diyaudioby/thsada/docs/thsada-sch.png

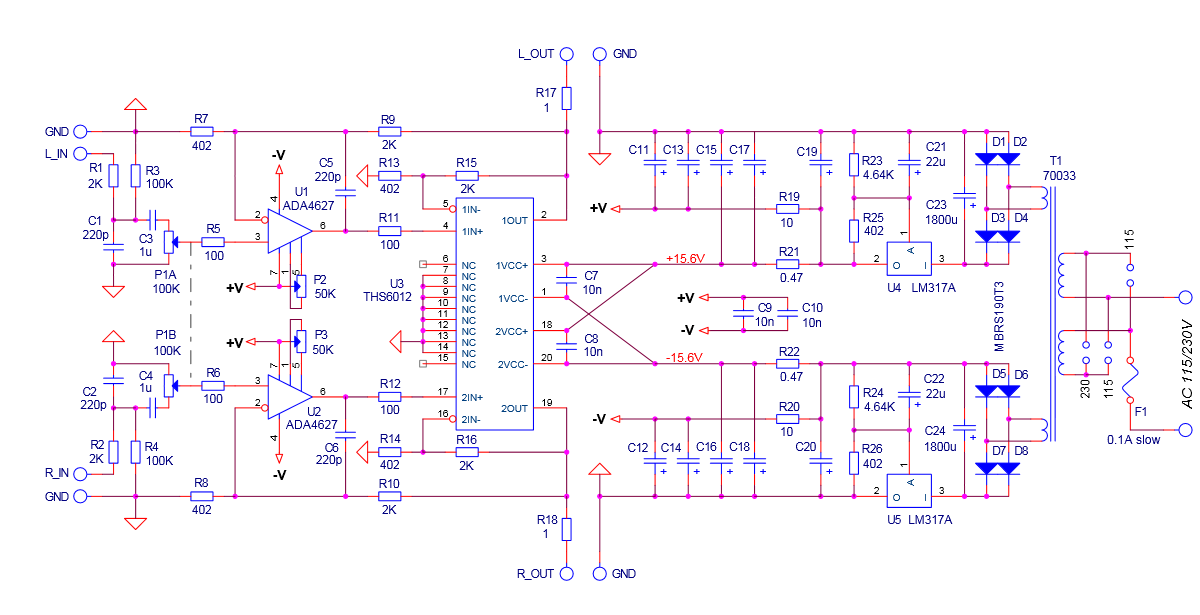
docs/thsada-sch.png
