diyaudioby/thsada/bom/thsada-bom.xlsx

Reference | Value | Case | Manufacture | Manufacture PN | Digikey PN | Qty 1
C1,C2,C5,C6 | 220pF x 50V 5% (NPO) | SMD 1206 | Yageo | CC1206JRNPO9BN221 | 311-1433-1-ND | 4
C3,C4 | 1uF x 63V 2% (LS 15mm) |  | Vishay BC Components | BFC241671005 | BC2076-ND | 2
C7…C10 | 10nF x 50V 5% (NPO) | SMD 1206 | Murata | GRM3195C1H103JA01D | 490-1754-1-ND | 4
C11…C14 | 100uF x 25V | TH D6.3xH12.7/LS=2.5mm | Panasonic (FM) | EEU-FM1E101 | P12924-ND | 4
C15…C18 | 470uF x 25V | TH D10xH17.5/LS=5mm | Panasonic (FM) | EEU-FM1E471 | P12388-ND | 4
C19…C22 | 22uF x 50V | TH D5xH12.5/LS=2mm | Panasonic (FM) | EEU-FM1H220 | P12927-ND | 4
C23,C24 | 1800uF x 35V | TH D16xH27/LS=7.5mm | Panasonic (FM) | EEU-FM1V182 | P12410-ND | 2
R1,R2,R9,R10,R15,R16 | 2k 1% 0.25W | SMD 1206 | Yageo | RC1206FR-072KL | 311-2.00KFRCT-ND | 6
R3,R4 | 100k 1% 0.25W | SMD 1206 | Yageo | RC1206FR-07100KL | 311-100KFRCT-ND | 2
R5,R6,R11,R12 | 100 1% 0.25W | SMD 1206 | Yageo | RC1206FR-07100RL | 311-100FRCT-ND | 4
R7,R8,R13,R14,R25,R26 | 402 Om 1% 0.25W | SMD 1206 | Yageo | RC1206FR-07402RL | 311-402FRCT-ND | 6
R17,R18 | 1 Om 5% 0.5W |  | Yageo | CFR-50JB-52-1R | 1.0H-ND | 2
R19,R20 | 11 Om 1% 0.25W | SMD 1206 | Yageo | RC1206FR-0711RL | 311-11.0FRCT-ND | 2
R21,R22 | 0.47 Om 0.5W
R23,R24 | 4.64k 1% 0.25W | SMD 1206 | Yageo | RC1206FR-074K64L | 311-4.64KFRCT-ND | 2
U1,U2 | ADA4627 | SOIC-8 | Analog Devices | ADA4627-1ARZ | ADA4627-1ARZ-ND | 2
U3 | THS6012 | SOIC-20 | Texas Instruments | THS6012IDWP | 296-1767-5-ND | 1
U4,U5 | LM317AT | TO-220-3 | Texas Instruments | LM317AT | LM317AT-ND | 2
D1…D8 | MBRS190 | SMB | ON Semiconductor | MBRS190T3G | MBRS190T3GOSCT-ND | 8
T1 | Transformer 2x15V |  | Amveco | 70033K | TE70033-ND | 1
P1 | RK27 100K LOG DUAL |  | Alps |  |  | 1
F1 | Fuseholder |  | Littelfuse | 64900001039 | WK0011-ND | 1
F1 | Fuse 0.1A slow |  | BelFuse | 5ST 100-R | 507-1238-ND | 1
