diyaudioby/thsada/docs/thsada-pcb.pdf

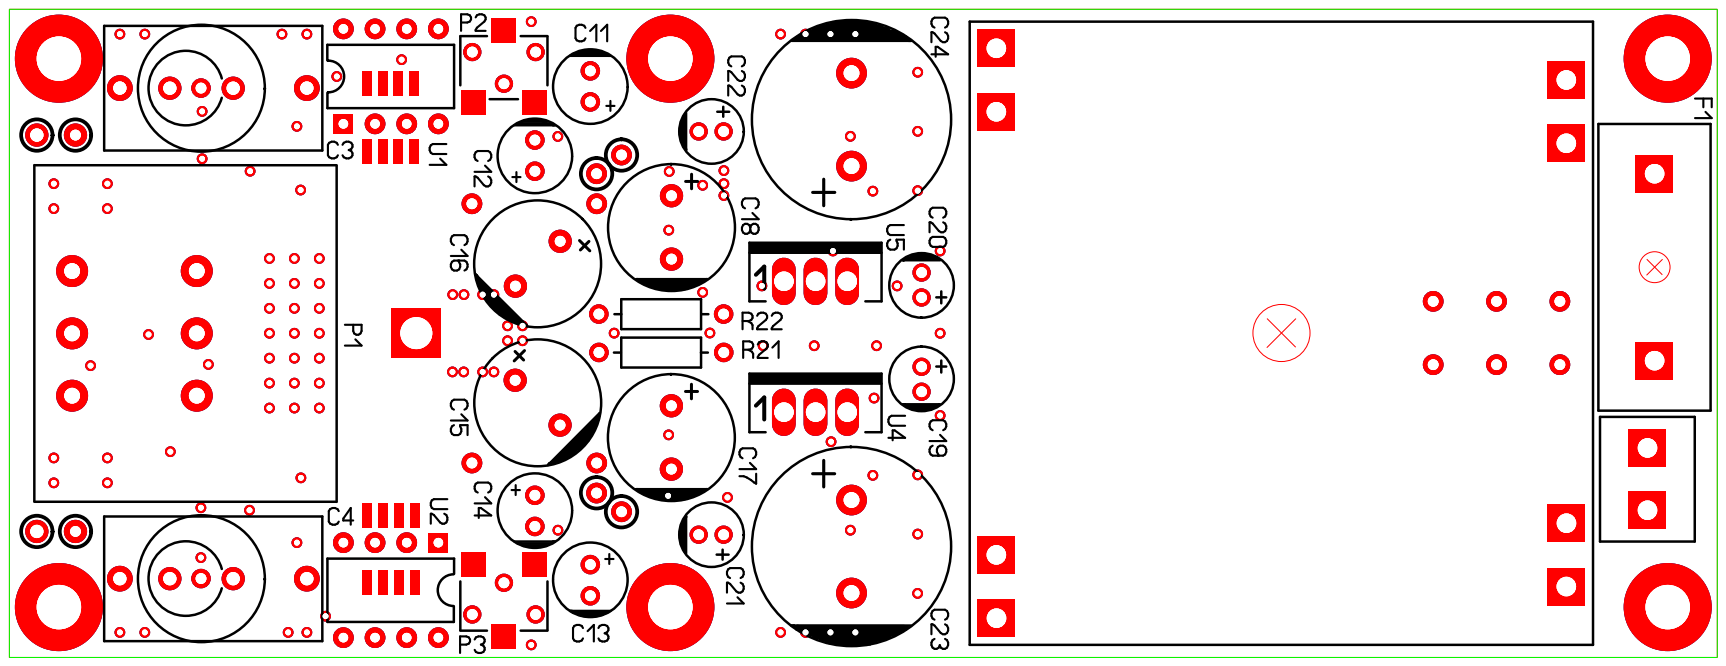
[picture p7: page 1]

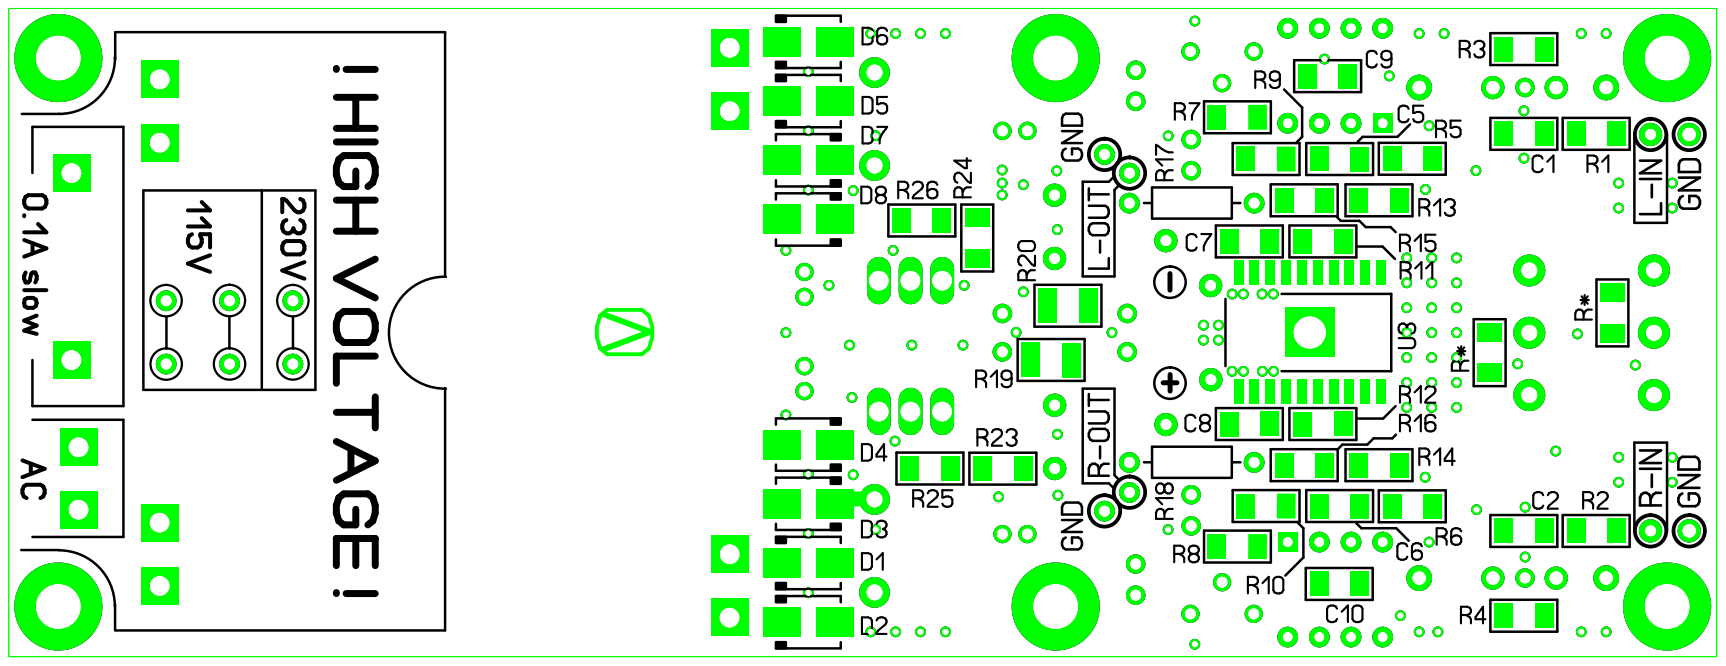
[picture p8: page 2]
