diyaudioby/thsada/(list of files, drawings)

Other design files:
pcb/thsada-pcb.LAY
